UzixLS/murmulator1010-board/release/pcb.rev.A1.pdf

1 | 2 | 3 | 4 | 5 | 6 | 7 | 8 | 9

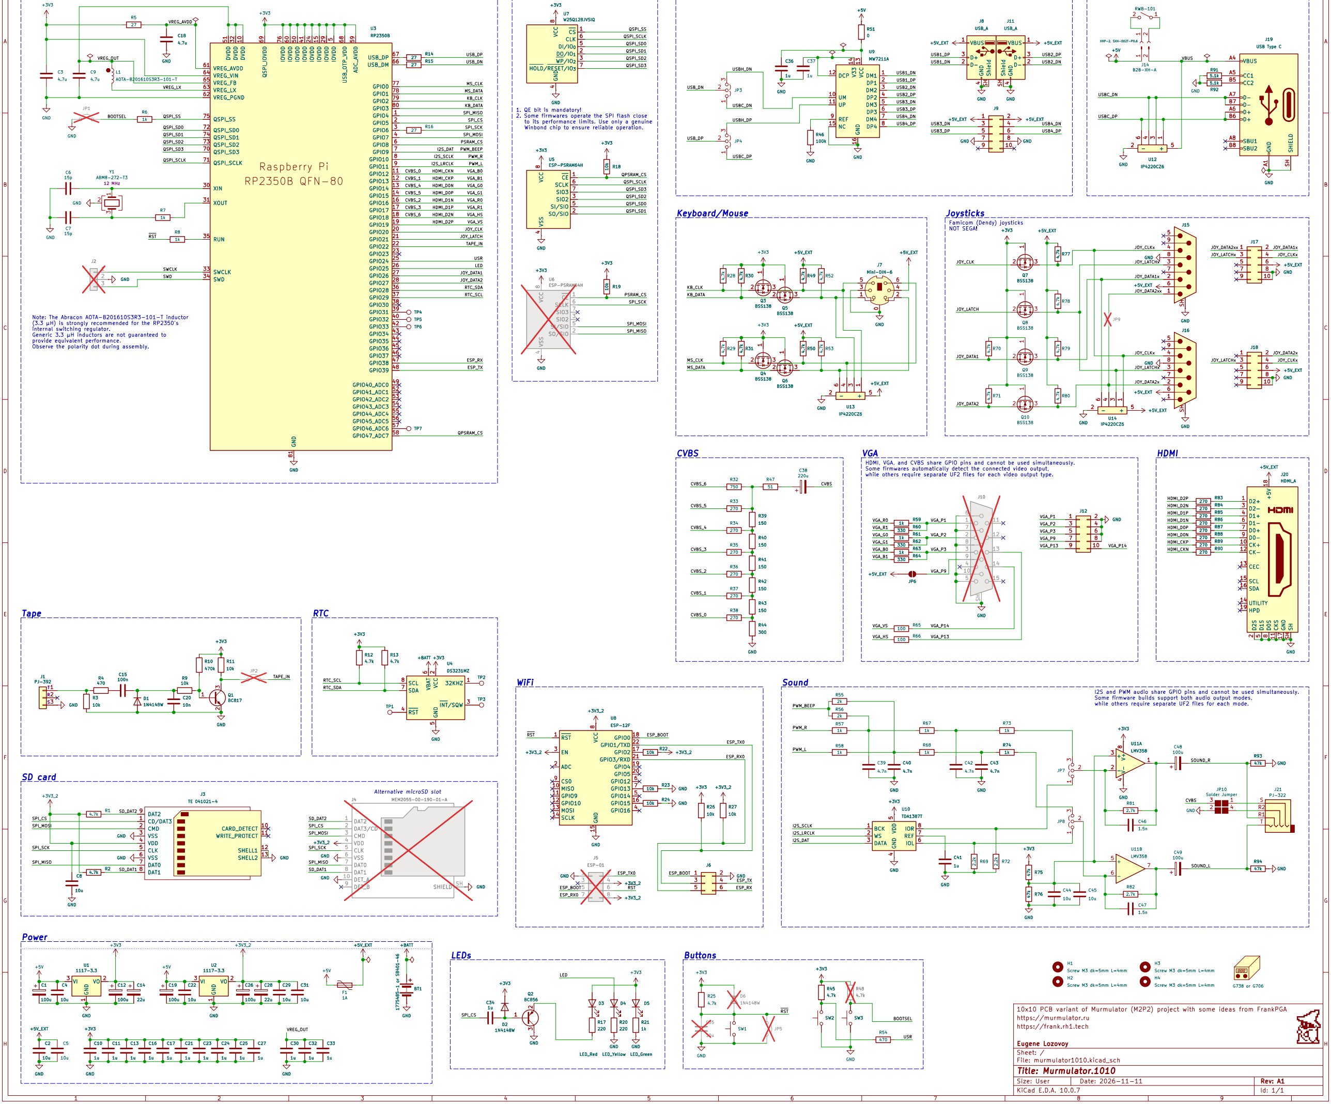
[picture p5: figure]
FGH; FGH Date: 2026-11-11; KiCad E.D.A. 10.0.7; Size: User; Rev: A1; Title: Murmulator.1010; File: murmulator1010.kicad_sch; Sheet: /; Eugene Lozovoy; https://frank.rh1.tech; https://murmulator.ru; GND; GND 1; GND +3V3 GND; 10k GND; JP3 R18 10k +3V3 GND; 10k +3V3_2 +3V3_2 GND; ESP-01; J6 R22 10k RST 1; ADC 2; ESP-12F +3V3_2; +3V3_2 GND; SO/SIO 2; SIO2 3 VSS; SI/SIO 5; SCLK 6; SIO3 7 VCC; ESP-PSRAM64H; CKS 11 CK-; 12 CEC; 13 UTILITY 14; SCL 15; SDA 16; GND 17 +⁵V 18 HPD; J20 HDMI_A +3V3 CE 1; U5 ESP-PSRAM64H; 1u GND; 10u GND; GNDGND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
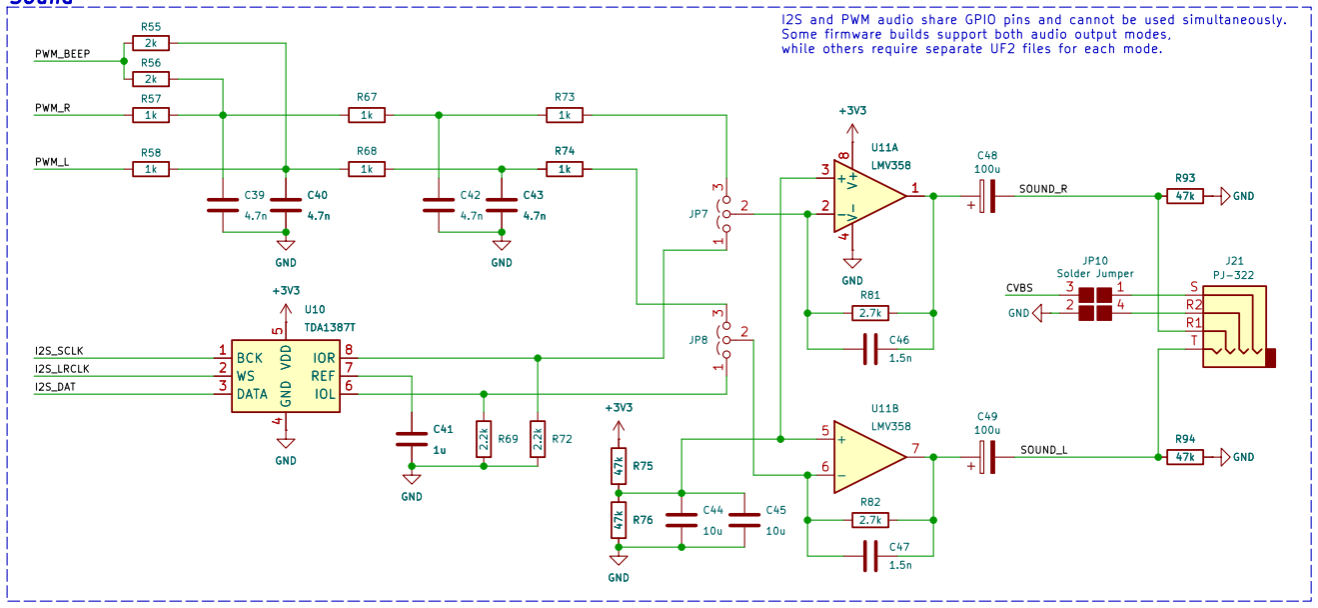
[picture p6: figure]

## 10x10 PCB variant of Murmulator (M2P2) project with some ideas from FrankPGA

EN 3 | GPIO16 4 GPIO14 5 GPIO12 6 GPIO13 7 VCC

# 8 CS0 9 MISO 10 GPIO9 11 GPIO10 12 MOSI 13

SCLK 14 | GND 15 | GPIO15 16 GPIO2 17 GPIO0 18 GPIO4 19 GPIO5 20 GPIO3/RXD 21 GPIO1/TXD 22
GND +5V_EXT | BT1 1775485⁻¹ or S8401⁻⁴⁶ GND +BATT
GND DM1 1 DP1 2 DM2 3 DP2 4 DM3 5 DP3 6 DM4 7 DP4 8 REF 9 UM 10 UP 11 DCP 12 | VCC 13 V33 14 NC 15 | GND 16

5 GPIO8 6 GPIO9 7 GPIO10 8 GPIO11 9 DVDD 10 GPIO12 11 GPIO13 12 GPIO14 13 GPIO15 14 IOVDD 15 GPIO16 16 GPIO17 17 GPIO18 18 GPIO19 19 GPIO20 20 GPIO21 21 GPIO22 22 GPIO23 23 IOVDD 24 GPIO24 25 GPIO25 26 GPIO26 27 GPIO27 28 IOVDD 29

SWD 34 RUN 35 | GPIO28 36 GPIO29 37 GPIO30 38 GPIO31 39 GPIO32 40 IOVDD 41 | GPIO33 42 GPIO34 43 GPIO35 44 GPIO36 45 GPIO37 46 GPIO38 47 GPIO39 48 GPIO40_ADC0 49 IOVDD 50 DVDD 51

GPIO41_ADC1 52 GPIO42_ADC2 53 GPIO43_ADC3 54 GPIO44_ADC4 55 GPIO45_ADC5 56 GPIO46_ADC6 57 GPIO47_ADC7 58 ADC_AVDD 59 IOVDD 60

VREG_FB 65 | USB_DM 66 USB_DP 67 USB_OTP_VDD 68 QSPI_IOVDD 69 QSPI_SD3 70 QSPI_SCLK 71 QSPI_SD0 72 QSPI_SD2 73 QSPI_SD1 74 QSPI_SS 75 | IOVDD 76 | GPIO0 77 GPIO1 78 GPIO2 79 GPIO3 80 GND 81
VSS 6 | DAT0 7 | DAT1 8 | DAT2 9 | CARD_DETECT 10 WRITE_PROTECT 11

# VREG_LX QSPI_SD0 QSPI_SD1 QSPI_SD2 QSPI_SD3 QSPI_SS

QSPI_SCLK QSPI_SD1 QSPI_SD0 QSPI_SD3 QSPI_SD2 QPSRAM_CS | USBH_DN

KB_DATA SPI_MOSI QSPI_SCLK QSPI_SD3 QSPI_SD1 QSPI_SD2 QSPI_SD0

# MCU

HDMI, VGA, and CVBS share GPIO pins and cannot be used simultaneously. Some firmwares automatically detect the connected video output, while others require separate UF2 files for each video output type.

Note: The Abracon AOTA-B201610S3R3-101-T inductor (3.3 µH) is strongly recommended for the RP2350's

## internal switching regulator. Generic 3.3 µH inductors are not guaranteed to

provide equivalent performance. Observe the polarity dot during assembly.

## 1. QE bit is mandatory! 2. Some firmwares operate the SPI flash close

to its performance limits. Use only a genuine Winbond chip to ensure reliable operation.

Power in / USB device FLASH & RAM | USB hub

I2S and PWM audio share GPIO pins and cannot be used simultaneously. Some firmware builds support both audio output modes, while others require separate UF2 files for each mode. GND

100u | +5V_EXT | BT1 1775485⁻¹ or S8401⁻⁴⁶ GND +BATT +3V3_2 GND

## U3RP2350B GPIO4 1 GPIO5 2 GPIO6 3 GPIO7 4 IOVDD

5 GPIO8 6 GPIO9 7 GPIO10 8 GPIO11 9 DVDD 10 GPIO12 11 GPIO13 12 GPIO14 13 GPIO15 14 IOVDD 15 GPIO16 16 GPIO17 17 GPIO18 18 GPIO19 19 GPIO20 20 GPIO21 21 GPIO22 22 GPIO23 23 IOVDD 24 GPIO24 25 GPIO25 26 GPIO26 27 GPIO27 28 IOVDD 29

SWD 34 RUN 35 | GPIO28 36 GPIO29 37 GPIO30 38 GPIO31 39 GPIO32 40 IOVDD 41 | GPIO33 42 GPIO34 43 GPIO35 44 GPIO36 45 GPIO37 46 GPIO38 47 GPIO39 48 GPIO40_ADC0 49 IOVDD 50 DVDD 51

GPIO41_ADC1 52 GPIO42_ADC2 53 GPIO43_ADC3 54 GPIO44_ADC4 55 GPIO45_ADC5 56 GPIO46_ADC6 57 GPIO47_ADC7 58 ADC_AVDD 59 IOVDD 60

VREG_FB 65 | USB_DM 66 USB_DP 67 USB_OTP_VDD 68 QSPI_IOVDD 69 QSPI_SD3 70 QSPI_SCLK 71 QSPI_SD0 72 QSPI_SD2 73 QSPI_SD1 74 QSPI_SS 75 | IOVDD 76 | GPIO0 77 GPIO1 78 GPIO2 79 GPIO3 80 GND 81
VSS 6 | DAT0 7 | DAT1 8 | DAT2 9 | CARD_DETECT 10 WRITE_PROTECT 11

R31 4.7k R30 4.7k R19 10k +3V3 GND U7W25Q128JVSIQ CS 1 DO/IO1 2 WP/IO2 3 GND
+5V_EXT | +5V_EXT +5V R49 4.7k +5V_EXT Q3 BSS138 1
2 | 3⁺⁵V_EXT U9MW7211A DM1 1 DP1 2 DM2 3 DP2 4 DM3 5 DP3 6 DM4 7 DP4 8 REF 9 UM 10 UP 11 DCP 12 | VCC 13 V33 14 NC 15 | GND 16
EN 3 | GPIO16 4 GPIO14 5 GPIO12 6 GPIO13 7 VCC

# 8 CS0 9 MISO 10 GPIO9 11 GPIO10 12 MOSI 13

SCLK 14 | GND 15 | GPIO15 16 GPIO2 17 GPIO0 18 GPIO4 19 GPIO5 20 GPIO3/RXD 21 GPIO1/TXD 22

# R 1.60 mm 7.5 mm

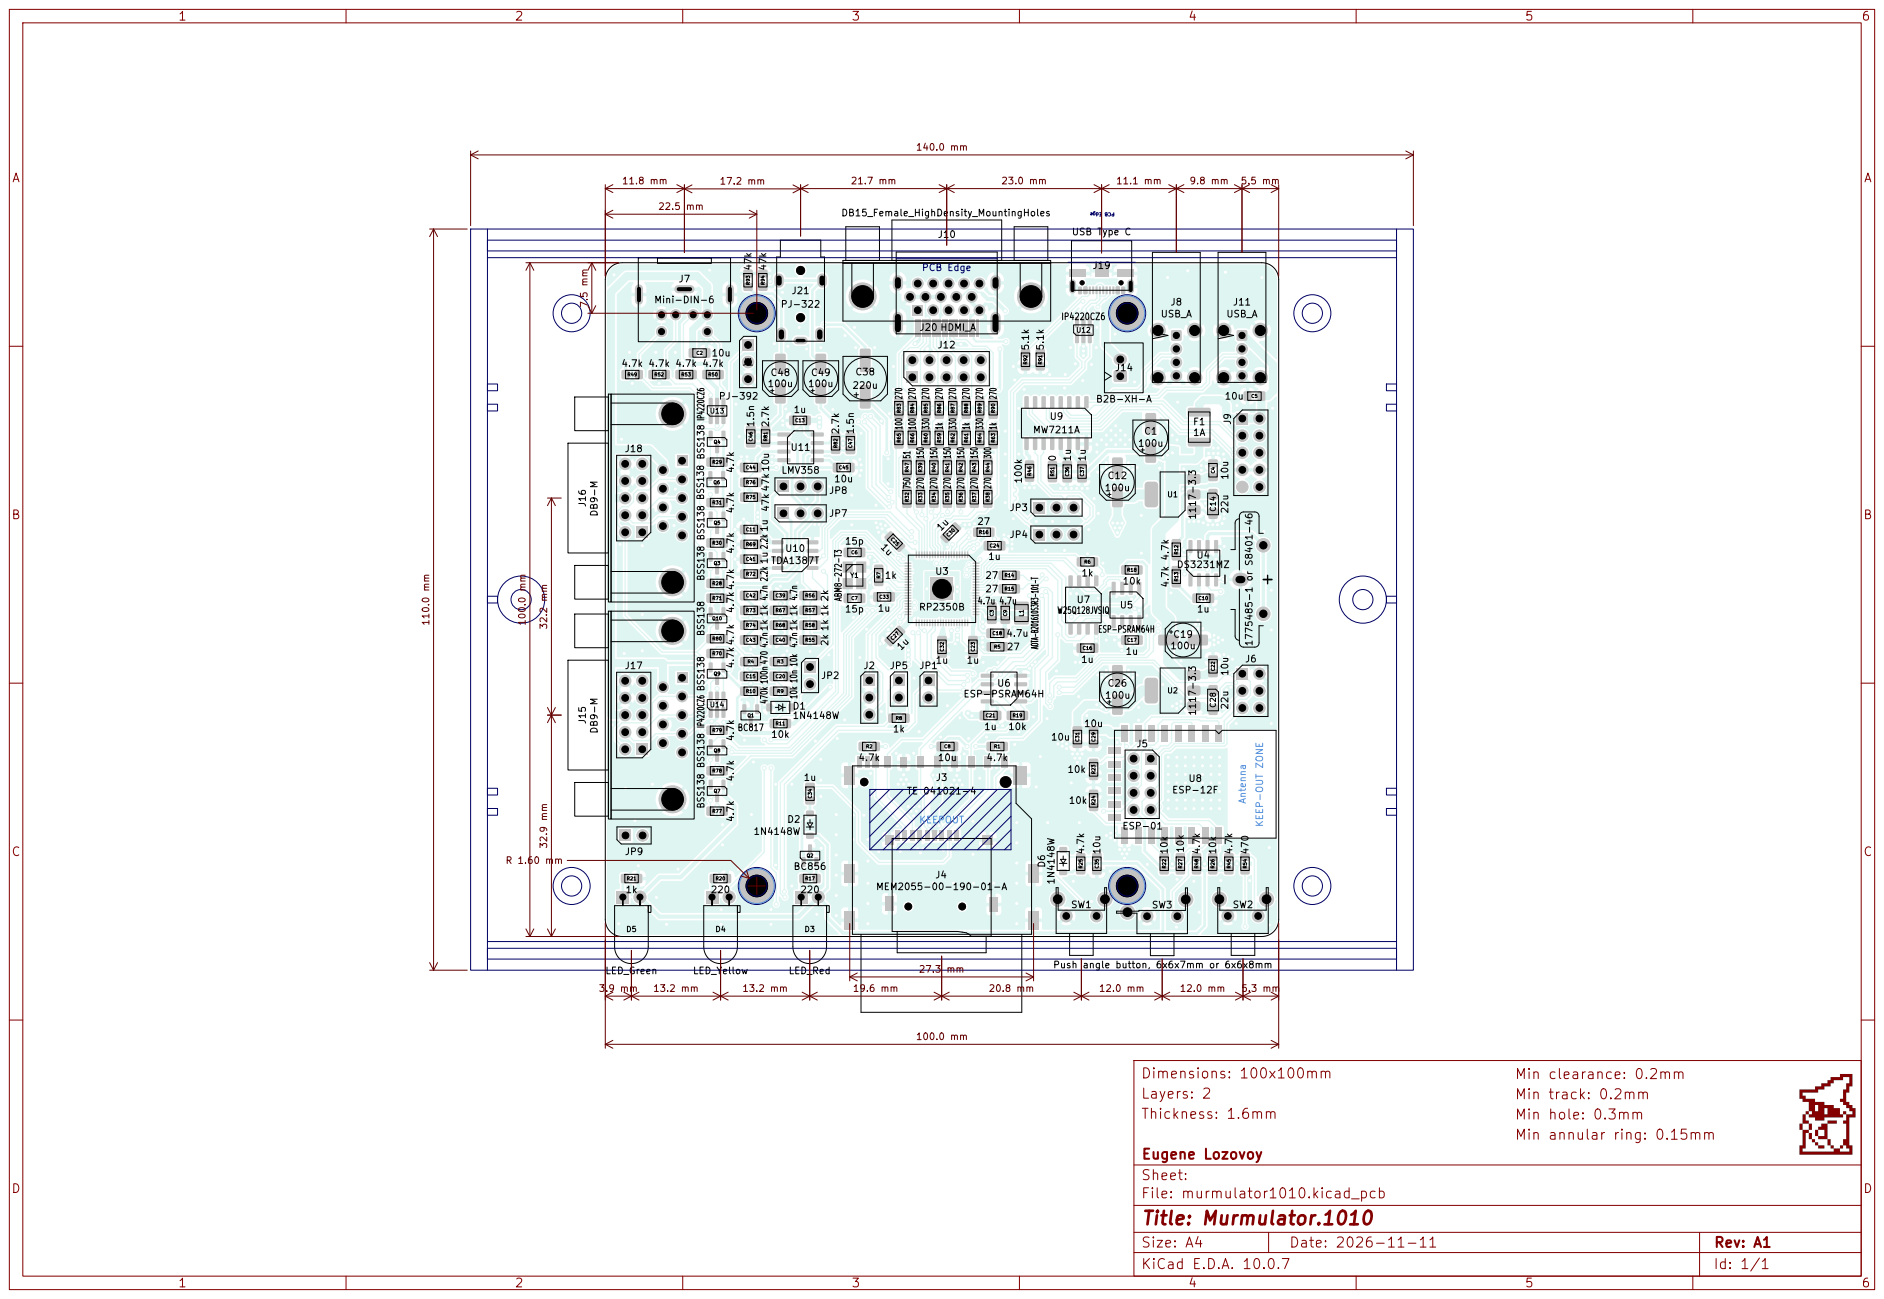
[picture p7: page 2]

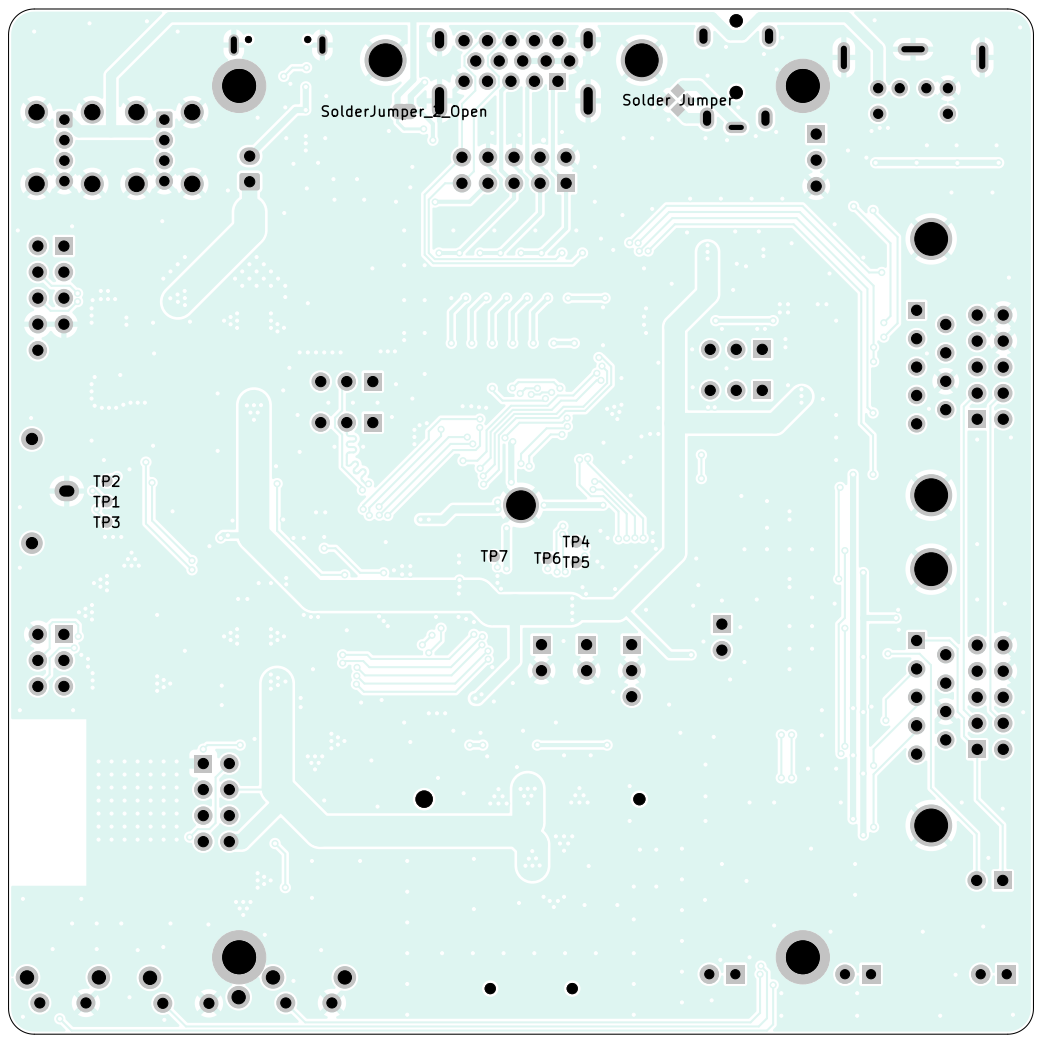
[picture p8: page 3]
D Date: 2026-11-11; KiCad E.D.A. 10.0.7; Size: A4; Rev: A1; Title: Murmulator.1010; File: murmulator1010.kicad_pcb; Sheet:; Eugene Lozovoy; Thickness: 1.6mm; Layers: 2; Dimensions: 100x100mm; Solder Jumper TP3; SolderJumper_2_Open

Min clearance: 0.2mm
Min track: 0.2mm
Min hole: 0.3mm
Min annular ring: 0.15mm

# Bill Of Materials

Refs | | | Value | Footprint | Qty
BT1 | 1775485-1 or S8401-46 | CR2032V | 1
C1 C12 C19 C26 C48 C49 | 100u | CP_Elec_5x5.9 | 6
C2 C4 C5 C8 C22 C29 C31 C44 C45 | 10u | C_0805_2012Metric_Pad1.18x1.45mm_Ha ndSolder | 9
C3 C9 C18 | 4.7u | C_0805_2012Metric_Pad1.18x1.45mm_Ha ndSolder | 3
C6 C7 | 15p | C_0805_2012Metric_Pad1.18x1.45mm_Ha ndSolder | 2
C10 C11 C13 C16 C17 C21 C23 C24 C25 C27 C30 C32 C33 C34 C36 C37 C41 | 1u | C_0805_2012Metric_Pad1.18x1.45mm_Ha ndSolder | 17
C14 C28 | 22u | CP_EIA-3216-18_Kemet-A_HandSolder | 2
C15 | 100n | C_0805_2012Metric_Pad1.18x1.45mm_Ha ndSolder | 1
C20 | 10n | C_0805_2012Metric_Pad1.18x1.45mm_Ha ndSolder | 1
C38 | 220u | CP_Elec_6.3x7.7 | 1
C39 C40 C42 C43 | 4.7n | C_0805_2012Metric_Pad1.18x1.45mm_Ha ndSolder | 4
C46 C47 | 1.5n | C_0805_2012Metric_Pad1.18x1.45mm_Ha ndSolder | 2
D1 D2 | 1N4148W | D_SOD-123 | 2
D3 | LED_Red | LED_D5.0mm_Horizontal_O1.27mm_Z3.0 mm | 1
D4 | LED_Yellow | LED_D5.0mm_Horizontal_O1.27mm_Z3.0 mm | 1
D5 | LED_Green | LED_D5.0mm_Horizontal_O1.27mm_Z3.0 mm | 1
F1 | 1A | Fuse_1812_4532Metric_Pad1.30x3.40mm _HandSolder | 1
H1 H2 H3 H4 | Screw M3 dk=5mm L=4mm | MountingHole_3.2mm_M3_dk5.2mm_Mas k | 4
J1 | PJ-392 | PinHeader_1x03_P2.54mm_Vertical | 1
J3 | TE 041021-4 | SD_TE_2041021-mod | 1
J6 | Conn_02x03_Odd_Even | PinHeader_2x03_P2.54mm_Vertical | 1
J7 | Mini-DIN-6 | minidin-6 | 1
J8 J11 | USB_A | USB_A_Wuerth_614004134726_Horizonta l | 2
J9 J12 J17 J18 | Conn_02x05_Odd_Even | PinHeader_2x05_P2.54mm_Vertical | 4
J13 | XHP-2 SXH-002T-P0.6 | | 1
J14 | B2B-XH-A | JST_XH_B2B-XH-A_1x02_P2.50mm_Vertic al | 1
J15 J16 | DB9-M | DSUB-9_Pins_Horizontal_P2.77x2.84mm_ EdgePinOffset7.70mm_Housed_Mounting HolesOffset9.12mm | 2

# murmulator1010 rev.A1 BOM page 1/3

J19 | USB Type C | USB_C_Receptacle_HRO_TYPE-C-31-M-12_ dangling | 1
J20 | HDMI_A | HDMI_A_Molex_208658-1001_Horizontal | 1
J21 | PJ-322 | PJ-322 | 1
L1 | AOTA-B201610S3R3-101-T | L_1008_2520Metric | 1
N1 | G738 or G706 | g738-g706 | 1
Q1 | BC817 | SOT-23 | 1
Q2 | BC856 | SOT-23 | 1
Q3 Q4 Q5 Q6 Q7 Q8 Q9 Q10 | BSS138 | SOT-23 | 8
R1 R2 R12 R13 R25 R28 R29 R30 R31 R45 R49 R50 R52 R53 R70 R71 R77 R78 R79 R80 | 4.7k | R_0805_2012Metric_Pad1.20x1.40mm_Ha ndSolder | 20
R3 R9 R11 R18 R19 R22 R23 R24 R26 R27 | 10k | R_0805_2012Metric_Pad1.20x1.40mm_Ha ndSolder | 10
R4 R54 | 470 | R_0805_2012Metric_Pad1.20x1.40mm_Ha ndSolder | 2
R5 R14 R15 R16 | 27 | R_0805_2012Metric_Pad1.20x1.40mm_Ha ndSolder | 4
R6 R7 R8 R21 R57 R58 R59 R61 R63 R67 R68 R73 R74 | 1k | R_0805_2012Metric_Pad1.20x1.40mm_Ha ndSolder | 13
R10 | 470k | R_0805_2012Metric_Pad1.20x1.40mm_Ha ndSolder | 1
R17 R20 | 220 | R_0805_2012Metric_Pad1.20x1.40mm_Ha ndSolder | 2
R32 | 750 | R_0805_2012Metric_Pad1.20x1.40mm_Ha ndSolder | 1
R33 R34 R35 R36 R37 R38 R83 R84 R85 R86 R87 R88 R89 R90 | 270 | R_0805_2012Metric_Pad1.20x1.40mm_Ha ndSolder | 14
R39 R40 R41 R42 R43 | 150 | R_0805_2012Metric_Pad1.20x1.40mm_Ha ndSolder | 5
R44 | 300 | R_0805_2012Metric_Pad1.20x1.40mm_Ha ndSolder | 1
R46 | 100k | R_0805_2012Metric_Pad1.20x1.40mm_Ha ndSolder | 1
R47 | 51 | R_0805_2012Metric_Pad1.20x1.40mm_Ha ndSolder | 1
R51 | 0 | R_0805_2012Metric_Pad1.20x1.40mm_Ha ndSolder | 1
R55 R56 | 2k | R_0805_2012Metric_Pad1.20x1.40mm_Ha ndSolder | 2
R60 R62 R64 | 330 | R_0805_2012Metric_Pad1.20x1.40mm_Ha ndSolder | 3
R65 R66 | 100 | R_0805_2012Metric_Pad1.20x1.40mm_Ha ndSolder | 2
R69 R72 | 2.2k | R_0805_2012Metric_Pad1.20x1.40mm_Ha ndSolder | 2
R75 R76 R93 R94 | 47k | R_0805_2012Metric_Pad1.20x1.40mm_Ha ndSolder | 4
R81 R82 | 2.7k | R_0805_2012Metric_Pad1.20x1.40mm_Ha ndSolder | 2

# murmulator1010 rev.A1 BOM page 2/3

R91 R92 | 5.1k | R_0805_2012Metric_Pad1.20x1.40mm_Ha ndSolder | 2
SW1 SW2 SW3 | Push angle button 6x6x7mm or 6x6x8mm | SW_Tactile_SPST_Angled_PTS645Vx58-2L FS | 3
SW4 | RWB-101 | | 1
U1 U2 | 1117-3.3 | SOT-223-3_TabPin2 | 2
U3 | RP2350B | QFN-80-1EP_10x10mm_P0.4mm_EP3.4x3. 4mm | 1
U4 | DS3231MZ | SOIC-8_3.9x4.9mm_P1.27mm | 1
U5 | ESP-PSRAM64H | SOIC-8_3.9x4.9mm_P1.27mm | 1
U7 | W25Q128JVSIQ | SOIC-8_5.3x5.3mm_P1.27mm | 1
U8 | ESP-12F ESP-12E | ESP-12E | 1
U9 | MW7211A | SOP-16_4.4x10.4mm_P1.27mm | 1
U10 | TDA1387T | SO-8_3.9x4.9mm_P1.27mm | 1
U11 | LMV358 | SOIC-8_3.9x4.9mm_P1.27mm | 1
U12 U13 U14 | IP4220CZ6 | SC-74-6_1.55x2.9mm_P0.95mm | 3
Y1 | ABM8-272-T3 | Crystal_SMD_3225-4Pin_3.2x2.5mm_Han dSoldering | 1

# murmulator1010 rev.A1 BOM page 3/3

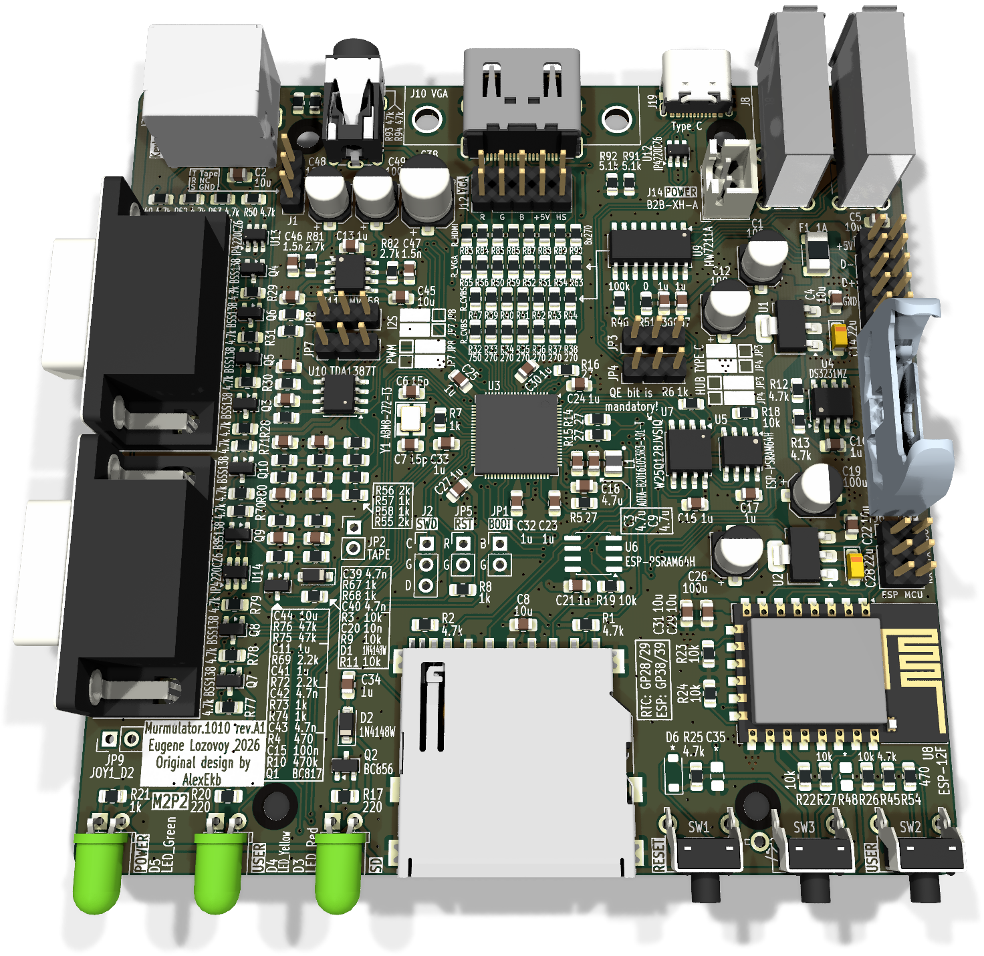
[picture p9: page 7]
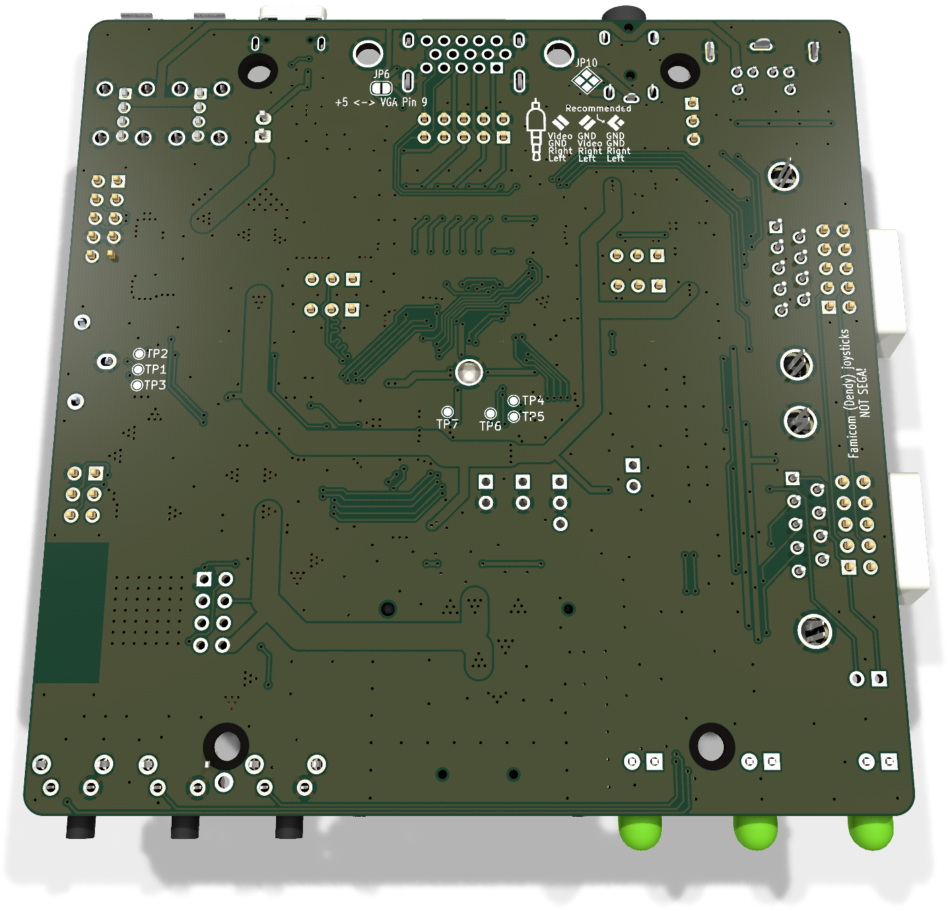
[picture p10: page 8]
