UzixLS/murmulator1010-board/pcb/rev.A1/murmulator1010.kicad_pcb

## KiCad design pcb/rev.A1/murmulator1010.kicad_pcb (2026-11-11)

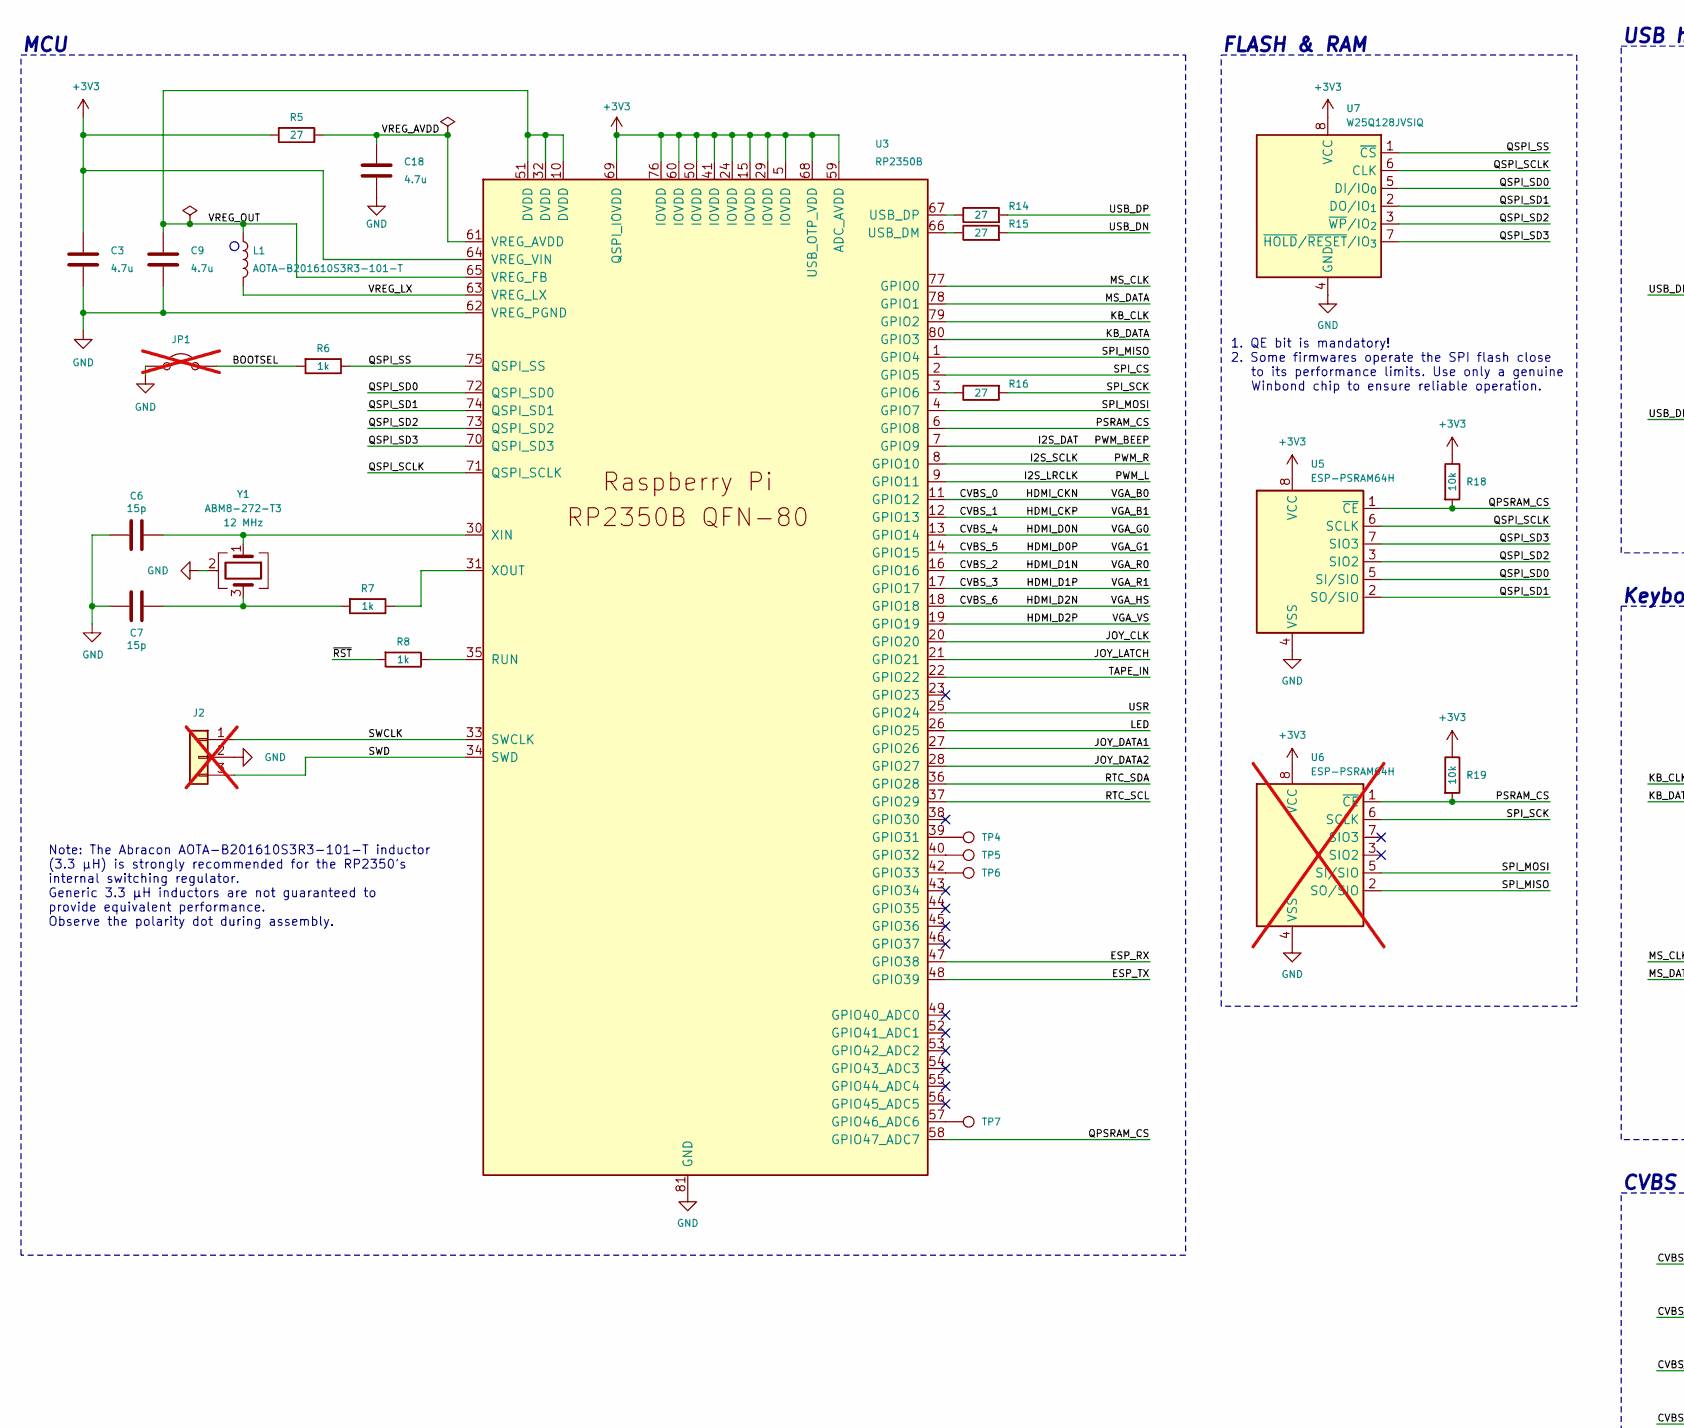
[picture p11: schematic murmulator1010.kicad_sch, Murmulator.1010, part in row 1, column 1]

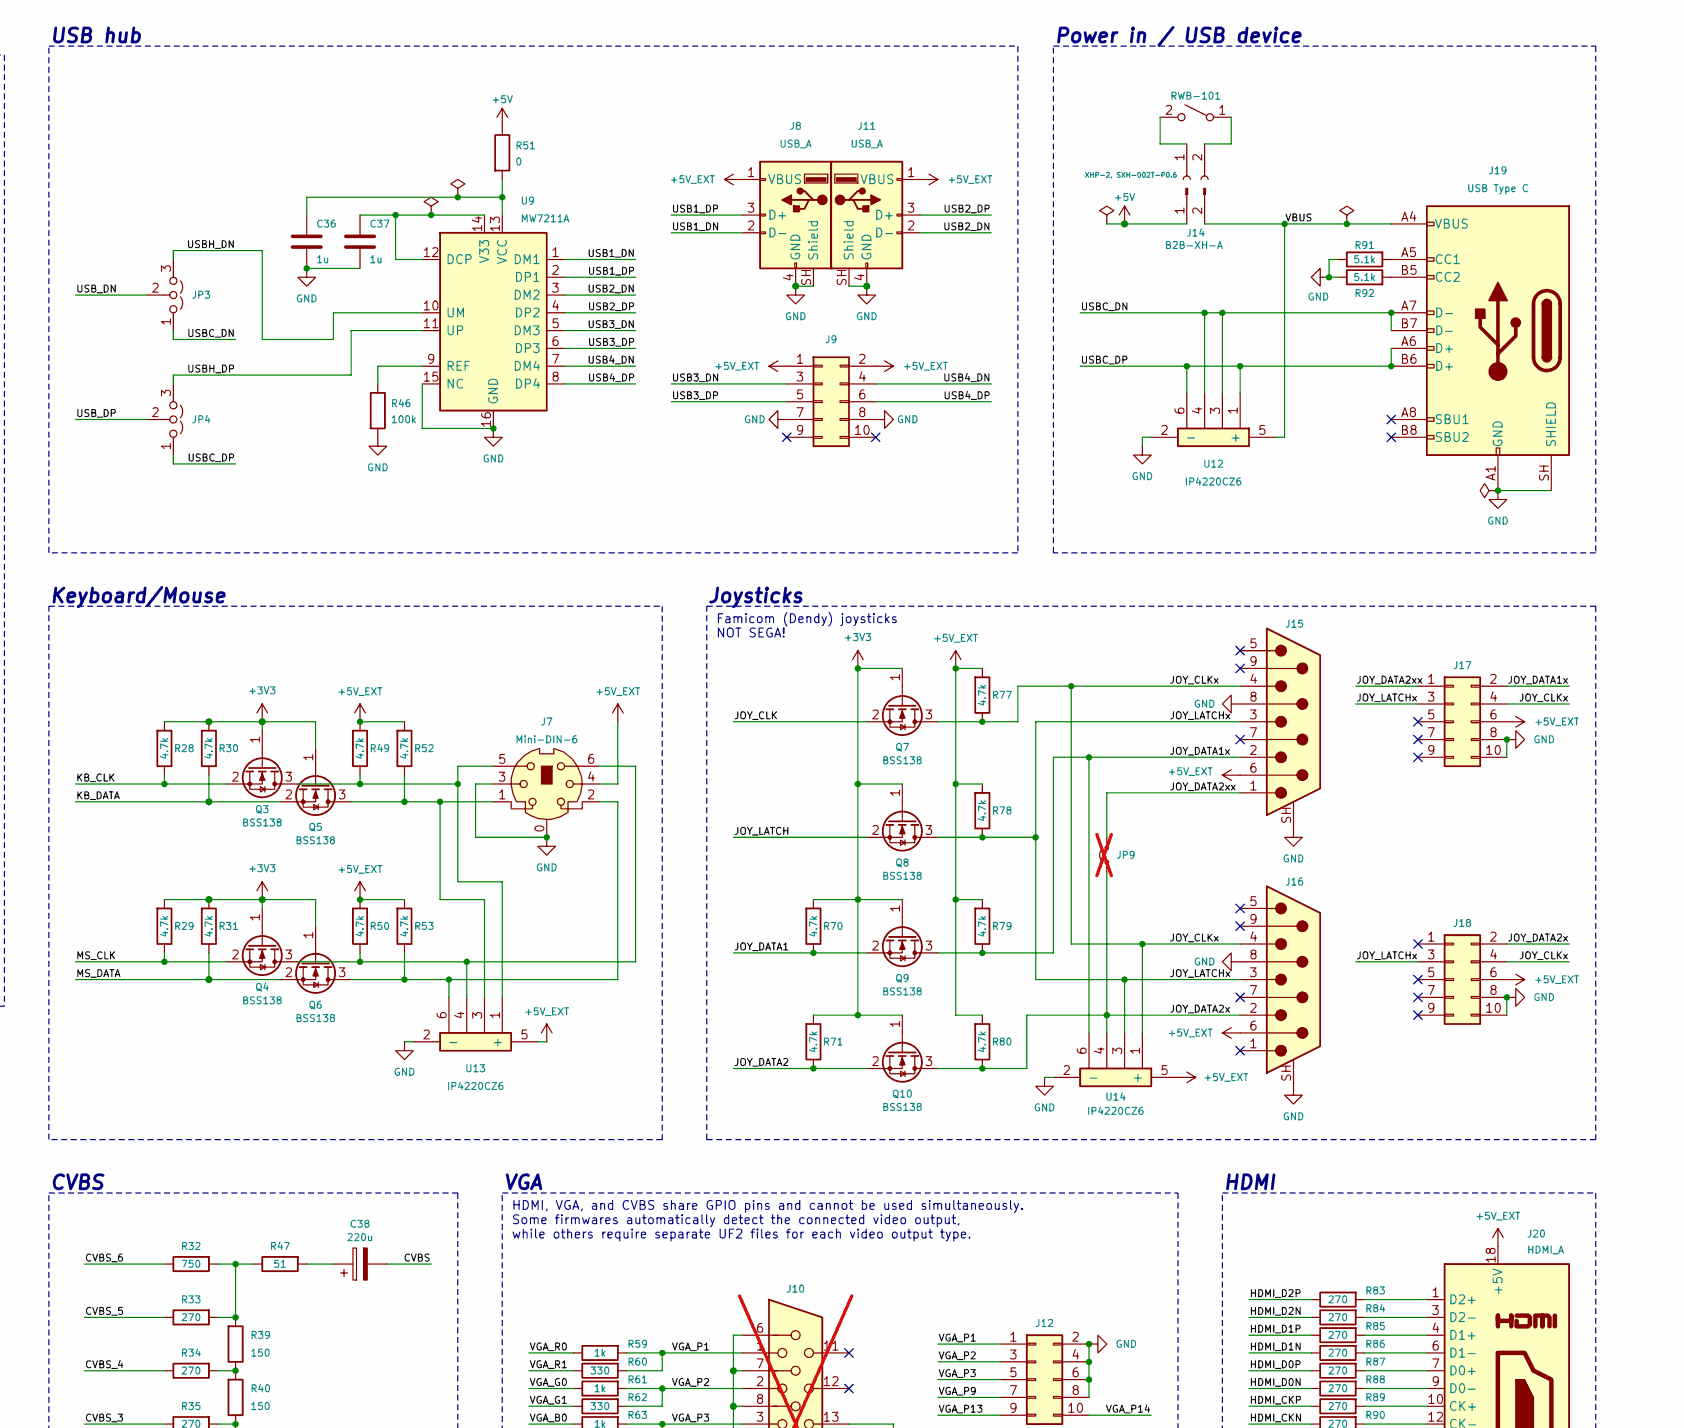
[picture p12: schematic murmulator1010.kicad_sch, Murmulator.1010, part in row 1, column 2]

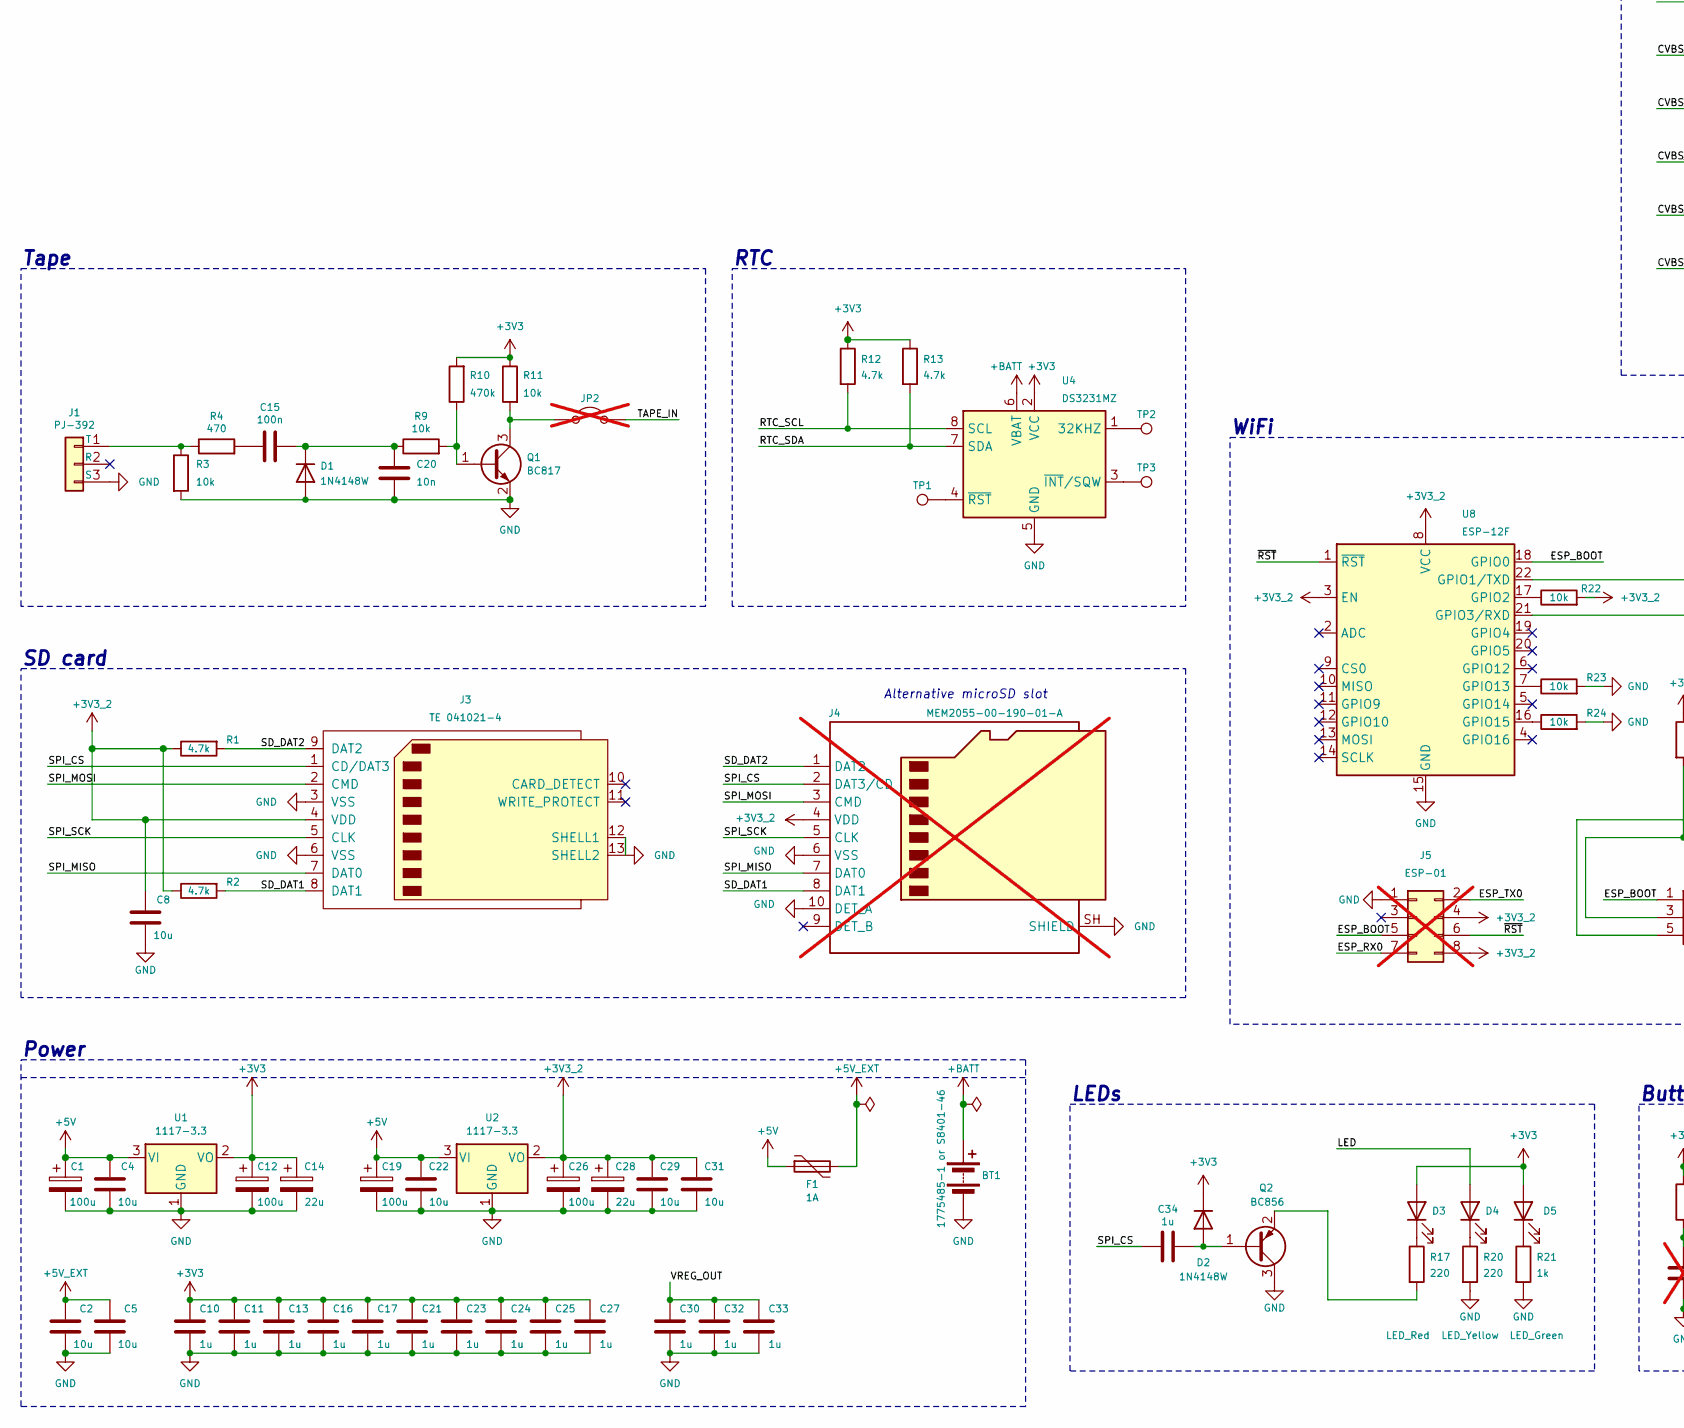
[picture p13: schematic murmulator1010.kicad_sch, Murmulator.1010, part in row 2, column 1]

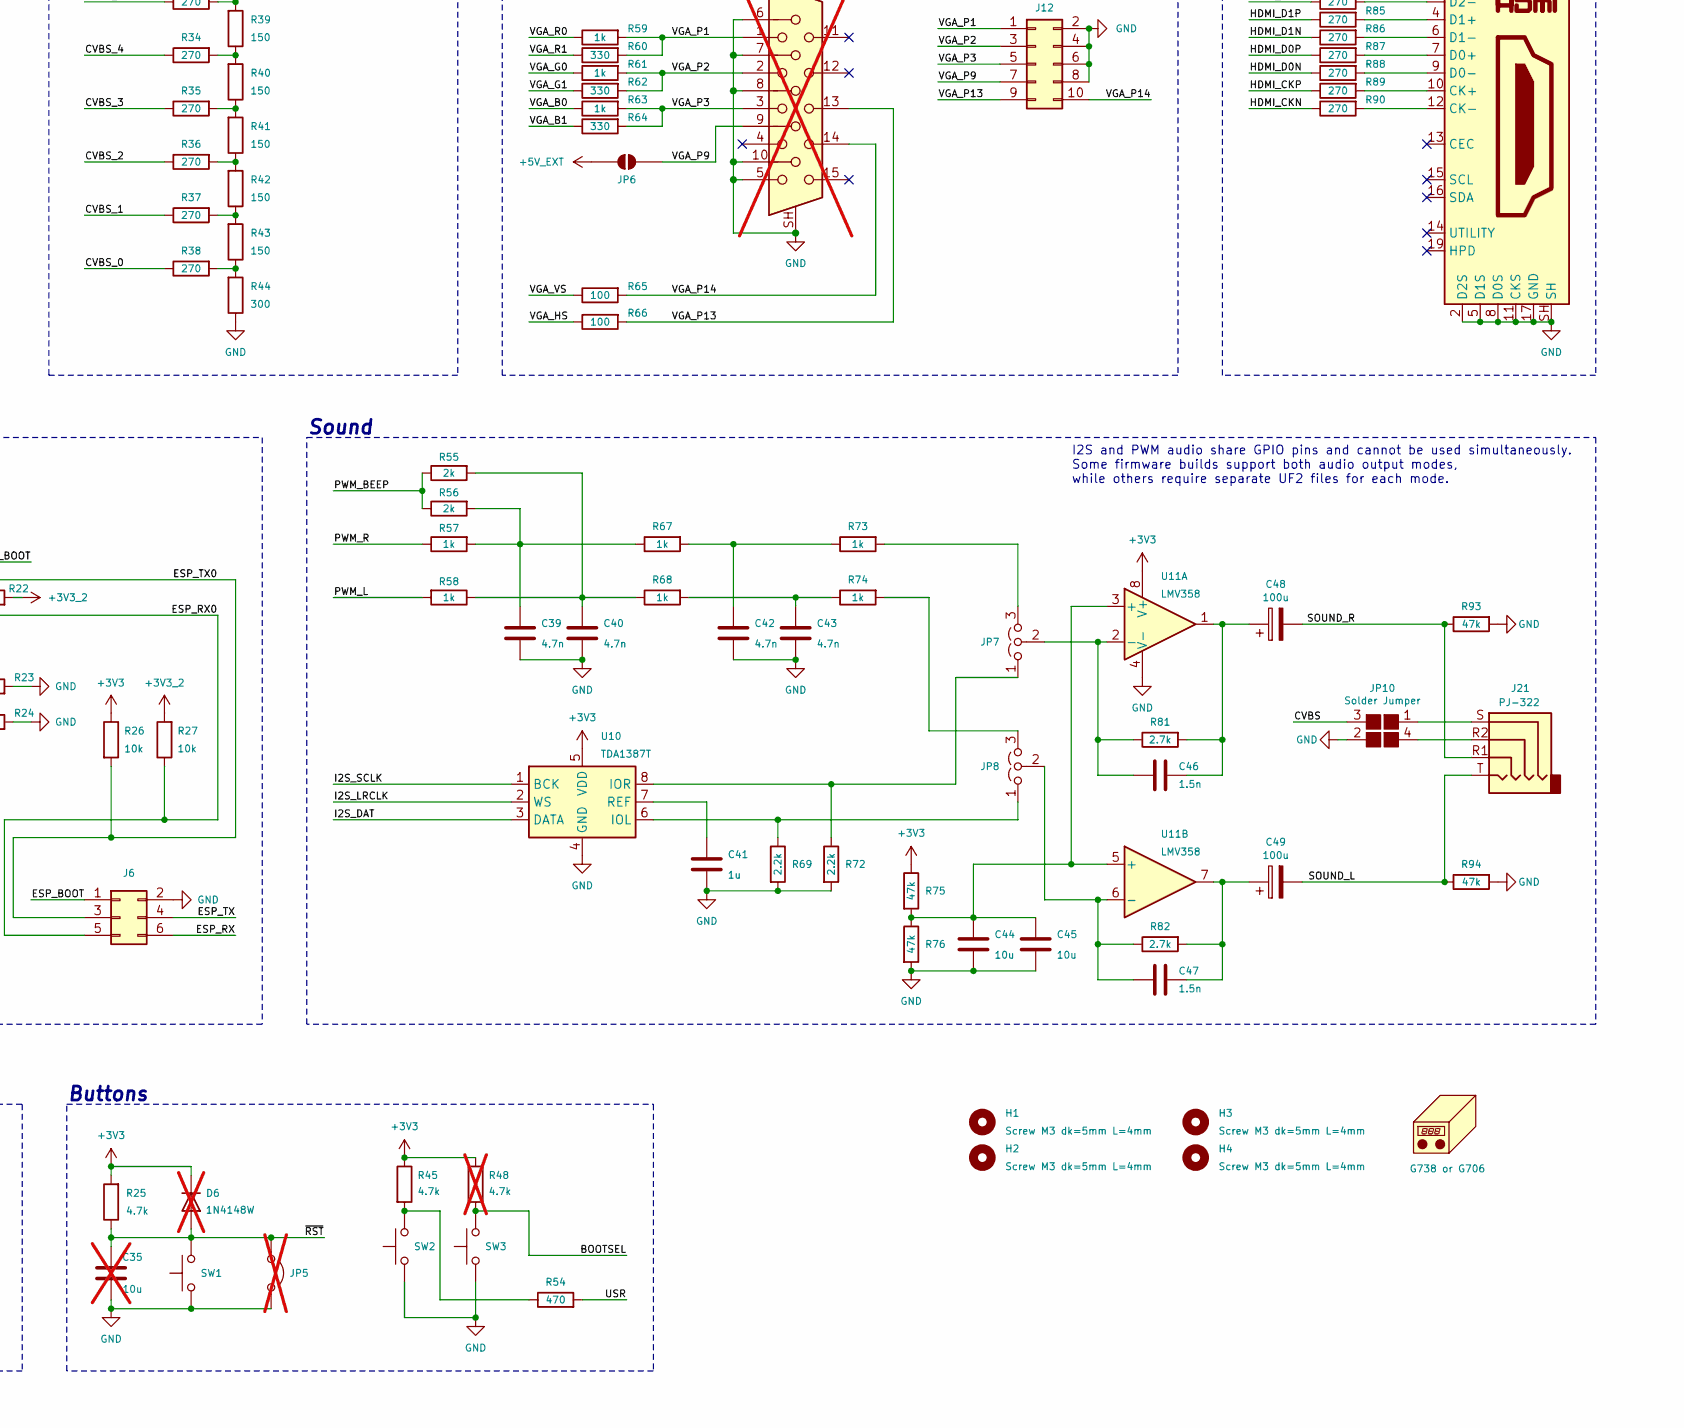
[picture p14: schematic murmulator1010.kicad_sch, Murmulator.1010, part in row 2, column 2]

Parts:
BT1: 1775485-1 or S8401-46; CR2032V
C1, C12, C19, C26, C48, C49: 100u; CP_Elec_5x5.9
C2, C4, C5, C8, C22, C29, C31, C44, C45: 10u; C_0805_2012Metric_Pad1.18x1.45mm_HandSolder
C3, C9, C18: 4.7u; C_0805_2012Metric_Pad1.18x1.45mm_HandSolder
C6, C7: 15p; C_0805_2012Metric_Pad1.18x1.45mm_HandSolder
C10, C11, C13, C16, C17, C21, C23, C24, C25, C27, C30, C32, C33, C34, C36, C37, C41: 1u; C_0805_2012Metric_Pad1.18x1.45mm_HandSolder
C14, C28: 22u; CP_EIA-3216-18_Kemet-A_HandSolder
C15: 100n; C_0805_2012Metric_Pad1.18x1.45mm_HandSolder
C20: 10n; C_0805_2012Metric_Pad1.18x1.45mm_HandSolder
C35: 10u; C_0805_2012Metric_Pad1.18x1.45mm_HandSolder; not fitted
C38: 220u; CP_Elec_6.3x7.7
C39, C40, C42, C43: 4.7n; C_0805_2012Metric_Pad1.18x1.45mm_HandSolder
C46, C47: 1.5n; C_0805_2012Metric_Pad1.18x1.45mm_HandSolder
D1, D2: 1N4148W; D_SOD-123
D3: LED_Red; LED_D5.0mm_Horizontal_O1.27mm_Z3.0mm
D4: LED_Yellow; LED_D5.0mm_Horizontal_O1.27mm_Z3.0mm
D5: LED_Green; LED_D5.0mm_Horizontal_O1.27mm_Z3.0mm
D6: 1N4148W; D_SOD-123; not fitted
F1: 1A; Fuse_1812_4532Metric_Pad1.30x3.40mm_HandSolder
H1, H2, H3, H4: Screw M3 dk=5mm L=4mm; MountingHole_3.2mm_M3_dk5.2mm_Mask
J1: PJ-392; PinHeader_1x03_P2.54mm_Vertical
J2: Conn_01x03; PinHeader_1x03_P2.54mm_Vertical; not fitted
J3: TE 041021-4; SD_TE_2041021-mod
J4: MEM2055-00-190-01-A; microSD_GCT-MEM2055-00-190-01-A; not fitted
J5: ESP-01; PinSocket_2x04_P2.54mm_Vertical; not fitted
J6: Conn_02x03_Odd_Even; PinHeader_2x03_P2.54mm_Vertical
J7: Mini-DIN-6; minidin-6
J8, J11: USB_A; USB_A_Wuerth_614004134726_Horizontal
J9, J12, J17, J18: Conn_02x05_Odd_Even; PinHeader_2x05_P2.54mm_Vertical
J10: DB15_Female_HighDensity_MountingHoles; DSUB-15-HD_Female_Horizontal_P2.29x1.98mm_EdgePinOffset3.03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; not fitted
J13: XHP-2, SXH-002T-P0.6
J14: B2B-XH-A; JST_XH_B2B-XH-A_1x02_P2.50mm_Vertical
J15, J16: DB9-M; DSUB-9_Pins_Horizontal_P2.77x2.84mm_EdgePinOffset7.70mm_Hou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
J19: USB Type C; USB_C_Receptacle_HRO_TYPE-C-31-M-12_dangling
J20: HDMI_A; HDMI_A_Molex_208658-1001_Horizontal
J21: PJ-322
JP1, JP2: Jumper_2_Open; PinHeader_1x02_P2.54mm_Vertical; not fitted
JP3, JP4, JP7, JP8: Jumper_3_Open; PinHeader_1x03_P2.54mm_Vertical
JP5, JP9: Jumper_2_Small_Open; PinHeader_1x02_P2.54mm_Vertical; not fitted
JP6: SolderJumper_2_Open; SolderJumper-2_P1.3mm_Open_RoundedPad1.0x1.5mm
JP10: Solder Jumper; SolderJumper-4_P1.3mm_Open
L1: AOTA-B201610S3R3-101-T; L_1008_2520Metric
N1: G738 or G706; g738-g706
Q1: BC817; SOT-23
Q2: BC856; SOT-23
Q3, Q4, Q5, Q6, Q7, Q8, Q9, Q10: BSS138; SOT-23
R1, R2, R12, R13, R25, R28, R29, R30, R31, R45, R49, R50, R52, R53, R70, R71, R77, R78, R79, R80: 4.7k; R_0805_2012Metric_Pad1.20x1.40mm_HandSolder
R3, R9, R11, R18, R19, R22, R23, R24, R26, R27: 10k; R_0805_2012Metric_Pad1.20x1.40mm_HandSolder
R4, R54: 470; R_0805_2012Metric_Pad1.20x1.40mm_HandSolder
R5, R14, R15, R16: 27; R_0805_2012Metric_Pad1.20x1.40mm_HandSolder
R6, R7, R8, R21, R57, R58, R59, R61, R63, R67, R68, R73, R74: 1k; R_0805_2012Metric_Pad1.20x1.40mm_HandSolder
R10: 470k; R_0805_2012Metric_Pad1.20x1.40mm_HandSolder
R17, R20: 220; R_0805_2012Metric_Pad1.20x1.40mm_HandSolder
R32: 750; R_0805_2012Metric_Pad1.20x1.40mm_HandSolder
R33, R34, R35, R36, R37, R38, R83, R84, R85, R86, R87, R88, R89, R90: 270; R_0805_2012Metric_Pad1.20x1.40mm_HandSolder
R39, R40, R41, R42, R43: 150; R_0805_2012Metric_Pad1.20x1.40mm_HandSolder
R44: 300; R_0805_2012Metric_Pad1.20x1.40mm_HandSolder
R46: 100k; R_0805_2012Metric_Pad1.20x1.40mm_HandSolder
R47: 51; R_0805_2012Metric_Pad1.20x1.40mm_HandSolder
R48: 4.7k; R_0805_2012Metric_Pad1.20x1.40mm_HandSolder; not fitted
R51: 0; R_0805_2012Metric_Pad1.20x1.40mm_HandSolder
R55, R56: 2k; R_0805_2012Metric_Pad1.20x1.40mm_HandSolder
R60, R62, R64: 330; R_0805_2012Metric_Pad1.20x1.40mm_HandSolder
R65, R66: 100; R_0805_2012Metric_Pad1.20x1.40mm_HandSolder
R69, R72: 2.2k; R_0805_2012Metric_Pad1.20x1.40mm_HandSolder
R75, R76, R93, R94: 47k; R_0805_2012Metric_Pad1.20x1.40mm_HandSolder
R81, R82: 2.7k; R_0805_2012Metric_Pad1.20x1.40mm_HandSolder
R91, R92: 5.1k; R_0805_2012Metric_Pad1.20x1.40mm_HandSolder
SW1, SW2, SW3: Push angle button, 6x6x7mm or 6x6x8mm; SW_Tactile_SPST_Angled_PTS645Vx58-2LFS
SW4: RWB-101
TP1, TP2, TP3, TP4, TP5, TP6, TP7: TestPoint; TestPoint_Pad_D1.0mm
U1, U2: 1117-3.3; SOT-223-3_TabPin2
U3: RP2350B; QFN-80-1EP_10x10mm_P0.4mm_EP3.4x3.4mm
U4: DS3231MZ; SOIC-8_3.9x4.9mm_P1.27mm
U5: ESP-PSRAM64H; SOIC-8_3.9x4.9mm_P1.27mm
U6: ESP-PSRAM64H; SOIC-8_3.9x4.9mm_P1.27mm; not fitted
U7: W25Q128JVSIQ; SOIC-8_5.3x5.3mm_P1.27mm
U8: ESP-12F; ESP-12E
U9: MW7211A; SOP-16_4.4x10.4mm_P1.27mm
U10: TDA1387T; SO-8_3.9x4.9mm_P1.27mm
U11: LMV358; SOIC-8_3.9x4.9mm_P1.27mm
U12, U13, U14: IP4220CZ6; SC-74-6_1.55x2.9mm_P0.95mm
Y1: ABM8-272-T3; Crystal_SMD_3225-4Pin_3.2x2.5mm_HandSoldering

Connections:
+3V3: C3.1, C10.2, C11.2, C12.1, C13.2, C14.1, C16.2, C17.2, C21.2, C23.2, C24.2, C25.2, C27.2, D2.1 (K), D3.2 (A), D5.2 (A), D6.1 (K), Q3.1 (G), Q4.1 (G), Q5.1 (G), Q6.1 (G), Q7.1 (G), Q8.1 (G), Q9.1 (G), Q10.1 (G), R5.1, R10.2, R11.1, R12.1, R13.1, R18.1, R19.1, R25.2, R26.1, R28.2, R29.2, R30.2, R31.2, R45.1, R48.1, R70.2, R71.2, R75.1, U1.2 (VO), U3.5 (IOVDD), U3.15 (IOVDD), U3.24 (IOVDD), U3.29 (IOVDD), U3.41 (IOVDD), U3.50 (IOVDD), U3.59 (ADC_AVDD), U3.60 (IOVDD), U3.64 (VREG_VIN), U3.68 (USB_OTP_VDD), U3.69 (QSPI_IOVDD), U3.76 (IOVDD), U4.2 (VCC), U5.8 (VCC), U6.8 (VCC), U7.8 (VCC), U10.5 (VDD), U11.8 (V+)
+3V3_2: C8.2, C26.1, C28.1, C29.2, C31.2, J3.4 (VDD), J4.4 (VDD), J5.4, J5.8, R1.1, R2.1, R22.2, R27.2, U2.2 (VO), U8.3 (EN), U8.8 (VCC)
+5V: C1.1, C4.2, C19.1, C22.2, F1.1, J14.1, R51.1, U1.3 (VI), U2.3 (VI)
+5V_EXT: C2.2, C5.2, F1.2, J7.4, J8.1 (VBUS), J9.1, J9.2, J11.1 (VBUS), J15.6, J16.6, J17.6, J18.6, J20.18 (+5V), JP6.2 (B), R49.2, R50.2, R52.2, R53.2, R77.2, R78.2, R79.2, R80.2, U13.5 (+), U14.5 (+)
+BATT: BT1.1 (+), U4.6 (VBAT)
/BOOTSEL: JP1.1 (A), R6.2, R48.2, SW3.1
/CVBS: C38.2, JP10.3
/CVBS_0: R38.1, R63.1, R90.1, U3.11 (GPIO12)
/CVBS_1: R37.1, R64.1, R89.1, U3.12 (GPIO13)
/CVBS_2: R36.1, R59.1, R86.1, U3.16 (GPIO16)
/CVBS_3: R35.1, R60.1, R85.1, U3.17 (GPIO17)
/CVBS_4: R34.1, R61.1, R88.1, U3.13 (GPIO14)
/CVBS_5: R33.1, R62.1, R87.1, U3.14 (GPIO15)
/CVBS_6: R32.1, R66.1, R84.1, U3.18 (GPIO18)
/ESP_BOOT: J5.5, J6.1, U8.18 (GPIO0)
/ESP_RX: J6.6, U3.47 (GPIO38)
/ESP_RX0: J5.7, J6.5, R27.1, U8.21 (GPIO3/RXD)
/ESP_TX: J6.4, U3.48 (GPIO39)
/ESP_TX0: J5.2, J6.3, R26.2, U8.22 (GPIO1/TXD)
/HDMI_D2P: R65.1, R83.1, U3.19 (GPIO19)
/I2S_DAT: R55.1, R56.1, U3.7 (GPIO9), U10.3 (DATA)
/I2S_LRCLK: R58.2, U3.9 (GPIO11), U10.2 (WS)
/I2S_SCLK: R57.1, U3.8 (GPIO10), U10.1 (BCK)
/JOY_CLK: Q7.2 (S), U3.20 (GPIO20)
/JOY_CLKx: J15.4, J16.4, J17.4, J18.4, Q7.3 (D), R77.1, U14.1
/JOY_DATA1: Q9.2 (S), R70.1, U3.27 (GPIO26)
/JOY_DATA1x: J15.2, J17.2, Q9.3 (D), R79.1, U14.6
/JOY_DATA2: Q10.2 (S), R71.1, U3.28 (GPIO27)
/JOY_DATA2x: J16.2, J18.2, JP9.2 (B), Q10.3 (D), R80.1, U14.4
/JOY_DATA2xx: J15.1, J17.1, JP9.1 (A)
/JOY_LATCH: Q8.2 (S), U3.21 (GPIO21)
/JOY_LATCHx: J15.3, J16.3, J17.3, J18.3, Q8.3 (D), R78.1, U14.3
/KB_CLK: Q3.2 (S), R28.1, U3.79 (GPIO2)
/KB_DATA: Q5.2 (S), R30.1, U3.80 (GPIO3)
/LED: D4.2 (A), U3.26 (GPIO25)
/MS_CLK: Q4.2 (S), R29.1, U3.77 (GPIO0)
/MS_DATA: Q6.2 (S), R31.1, U3.78 (GPIO1)
/PSRAM_CS: R19.2, U3.6 (GPIO8), U6.1 (~CE)
/QPSRAM_CS: R18.2, U3.58 (GPIO47_ADC7), U5.1 (~CE)
/QSPI_SCLK: U3.71 (QSPI_SCLK), U5.6 (SCLK), U7.6 (CLK)
/QSPI_SD0: U3.72 (QSPI_SD0), U5.5 (SI/SIO), U7.5 (DI/IO_{0})
/QSPI_SD1: U3.74 (QSPI_SD1), U5.2 (SO/SIO), U7.2 (DO/IO_{1})
/QSPI_SD2: U3.73 (QSPI_SD2), U5.3 (SIO2), U7.3 (~WP/IO_{2})
/QSPI_SD3: U3.70 (QSPI_SD3), U5.7 (SIO3), U7.7 (~HOLD/~RESET/IO_{3})
/QSPI_SS: R6.1, U3.75 (QSPI_SS), U7.1 (~CS)
/RTC_SCL: R12.2, U3.37 (GPIO29), U4.8 (SCL)
/RTC_SDA: R13.2, U3.36 (GPIO28), U4.7 (SDA)
/SD_DAT1: J3.8 (DAT1), J4.8 (DAT1), R2.2
/SD_DAT2: J3.9 (DAT2), J4.1 (DAT2), R1.2
/SOUND_L: C49.2, J21.T, R94.1
/SOUND_R: C48.2, J21.R1, R93.1
/SPI_CS: C34.1, J3.1 (CD/DAT3), J4.2 (DAT3/CD), U3.2 (GPIO5)
/SPI_MISO: J3.7 (DAT0), J4.7 (DAT0), U3.1 (GPIO4), U6.2 (SO/SIO)
/SPI_MOSI: J3.2 (CMD), J4.3 (CMD), U3.4 (GPIO7), U6.5 (SI/SIO)
/SPI_SCK: J3.5 (CLK), J4.5 (CLK), R16.2, U6.6 (SCLK)
/SWCLK: J2.1, U3.33 (SWCLK)
/SWD: J2.3, U3.34 (SWD)
/TAPE_IN: JP2.1 (A), U3.22 (GPIO22)
/USB1_DN: J8.2 (D-), U9.1 (DM1)
/USB1_DP: J8.3 (D+), U9.2 (DP1)
/USB2_DN: J11.2 (D-), U9.3 (DM2)
/USB2_DP: J11.3 (D+), U9.4 (DP2)
/USB3_DN: J9.3, U9.5 (DM3)
/USB3_DP: J9.5, U9.6 (DP3)
/USB4_DN: J9.4, U9.7 (DM4)
/USB4_DP: J9.6, U9.8 (DP4)
/USBC_DN: J19.A7 (D-), J19.B7 (D-), JP3.1 (A), U12.3, U12.4
/USBC_DP: J19.A6 (D+), J19.B6 (D+), JP4.1 (A), U12.1, U12.6
/USBH_DN: JP3.3 (B), U9.10 (UM)
/USBH_DP: JP4.3 (B), U9.11 (UP)
/USB_DN: JP3.2 (C), R15.2
/USB_DP: JP4.2 (C), R14.2
/USR: R54.2, U3.25 (GPIO24)
/VBUS: J14.2, J19.A4 (VBUS), J19.A9 (VBUS), J19.B4 (VBUS), J19.B9 (VBUS), U12.5 (+)
/VGA_P1: J10.1, J12.1, R59.2, R60.2
/VGA_P2: J10.2, J12.3, R61.2, R62.2
/VGA_P3: J10.3, J12.5, R63.2, R64.2
/VGA_P9: J10.9, J12.7, JP6.1 (A)
/VGA_P13: J10.13, J12.9, R66.2
/VGA_P14: J10.14, J12.10, R65.2
/VREG_AVDD: C18.1, R5.2, U3.61 (VREG_AVDD)
/VREG_LX: L1.2, U3.63 (VREG_LX)
/VREG_OUT: C9.1, C30.2, C32.2, C33.2, L1.1, U3.10 (DVDD), U3.32 (DVDD), U3.51 (DVDD), U3.65 (VREG_FB)
/~RST: C35.2, D6.2 (A), J5.6, JP5.1 (A), R8.2, R25.1, SW1.1, U8.1 (~RST)
GND: BT1.2 (-), C1.2, C2.1, C3.2, C4.1, C5.1, C6.2, C7.2, C8.1, C9.2, C10.1, C11.1, C12.2, C13.1, C14.2, C16.1, C17.1, C18.2, C19.2, C20.2, C21.1, C22.1, C23.1, C24.1, C25.1, C26.2, C27.1, C28.2, C29.1, C30.1, C31.1, C32.1, C33.1, C35.1, C36.1, C37.1, C39.2, C40.2, C41.2, C42.2, C43.2, C44.2, C45.2, D1.2 (A), J1.3, J2.2, J3.3 (VSS), J3.6 (VSS), J3.12 (SHELL1), J3.13 (SHELL2), J4.6 (VSS), J4.10 (DET_A), J4.SH (SHIELD), J5.1, J6.2, J7.0, J7.3, J8.4 (GND), J8.SH (Shield), J9.7, J9.8, J10.5, J10.6, J10.7, J10.8, J10.10, J10.SH, J11.4 (GND), J11.SH (Shield), J12.2, J12.4, J12.6, J12.8, J15.8, J15.SH (PAD), J16.8, J16.SH (PAD), J17.8, J17.10, J18.8, J18.10, J19.A1 (GND), J19.A12 (GND), J19.B1 (GND), J19.B12 (GND), J19.SH (SHIELD), J20.2 (D2S), J20.5 (D1S), J20.8 (D0S), J20.11 (CKS), J20.17 (GND), J20.SH, JP1.2 (B), JP5.2 (B), JP10.2, Q1.2 (E), Q2.3 (C), R3.2, R20.2, R21.2, R23.2, R24.2, R44.1, R46.2, R69.2, R72.2, R76.2, R91.1, R92.1, R93.2, R94.2, SW1.2, SW2.2, SW3.2, U1.1 (GND), U2.1 (GND), U3.62 (VREG_PGND), U3.81 (GND), U4.5 (GND), U5.4 (VSS), U6.4 (VSS), U7.4 (GND), U8.15 (GND), U9.15 (NC), U9.16 (GND), U10.4 (GND), U11.4 (V-), U12.2 (-), U13.2 (-), U14.2 (-), Y1.2 (G), Y1.4 (G)
unnamed: C7.1, R7.2, Y1.3
unnamed: C15.2, R4.2
unnamed: C38.1, R47.2
unnamed: C39.1, R56.2, R57.2, R67.1
unnamed: C40.1, R55.2, R58.1, R68.1
unnamed: C42.1, R67.2, R73.1
unnamed: C43.1, R68.2, R74.1
unnamed: C46.1, C48.1, R81.2, U11.1
unnamed: C47.1, C49.1, R82.2, U11.7
unnamed: C15.1, C20.1, D1.1 (K), R9.1
unnamed: C34.2, D2.2 (A), Q2.1 (B)
unnamed: D3.1 (K), R17.1
unnamed: D4.1 (K), R20.1
unnamed: D5.1 (K), R21.1
unnamed: J1.1, R3.1, R4.1
unnamed: J13.1, SW4.2 (B)
unnamed: J13.2, SW4.1 (A)
unnamed: J19.A5 (CC1), R91.2
unnamed: J19.B5 (CC2), R92.2
unnamed: J20.10 (CK+), R89.2
unnamed: J20.12 (CK-), R90.2
unnamed: J20.7 (D0+), R87.2
unnamed: J20.9 (D0-), R88.2
unnamed: J20.4 (D1+), R85.2
unnamed: J20.6 (D1-), R86.2
unnamed: J20.1 (D2+), R83.2
unnamed: J20.3 (D2-), R84.2
unnamed: J21.R2, JP10.4
unnamed: JP2.2 (B), Q1.3 (C), R11.2
unnamed: JP7.1 (A), R72.1, U10.8 (IOR)
unnamed: JP7.3 (B), R73.2
unnamed: C46.2, JP7.2 (C), R81.1, U11.2 (-)
unnamed: JP8.1 (A), R69.1, U10.6 (IOL)
unnamed: JP8.3 (B), R74.2
unnamed: C47.2, JP8.2 (C), R82.1, U11.6 (-)
unnamed: J21.S, JP10.1 (A)
unnamed: Q1.1 (B), R9.2, R10.1
unnamed: Q2.2 (E), R17.2
unnamed: J7.5, Q3.3 (D), R49.1, U13.1
unnamed: J7.6, Q4.3 (D), R50.1, U13.4
unnamed: J7.1, Q5.3 (D), R52.1, U13.3
unnamed: J7.2, Q6.3 (D), R53.1, U13.6
unnamed: R32.2, R33.2, R39.2, R47.1
unnamed: R34.2, R39.1, R40.2
unnamed: R35.2, R40.1, R41.2
unnamed: R36.2, R41.1, R42.2
unnamed: R37.2, R42.1, R43.2
unnamed: R38.2, R43.1, R44.2
unnamed: R45.2, R54.1, SW2.1
unnamed: R16.1, U3.3 (GPIO6)
unnamed: TP4.1 (1_1), U3.39 (GPIO31)
unnamed: TP5.1 (1_1), U3.40 (GPIO32)
unnamed: TP6.1 (1_1), U3.42 (GPIO33)
unnamed: TP7.1 (1_1), U3.57 (GPIO46_ADC6)
unnamed: R8.1, U3.35 (RUN)
unnamed: R15.1, U3.66 (USB_DM)
unnamed: R14.1, U3.67 (USB_DP)
unnamed: C6.1, U3.30 (XIN), Y1.1
unnamed: R7.1, U3.31 (XOUT)
unnamed: TP2.1 (1_1), U4.1 (32KHZ)
unnamed: TP3.1 (1_1), U4.3 (~INT/SQW)
unnamed: TP1.1 (1_1), U4.4 (~RST)
unnamed: R22.1, U8.17 (GPIO2)
unnamed: R23.1, U8.7 (GPIO13)
unnamed: R24.1, U8.16 (GPIO15)
unnamed: C37.2, U9.12 (DCP), U9.14 (V33)
unnamed: R46.1, U9.9 (REF)
unnamed: C36.2, R51.2, U9.13 (VCC)
unnamed: C41.1, U10.7 (REF)
unnamed: C44.1, C45.1, R75.2, R76.1, U11.3 (+), U11.5 (+)

Notes on the sheet:
Famicom (Dendy) joysticks NOT SEGA!
I2S and PWM audio share GPIO pins and cannot be used simultaneously. Some firmware builds support both audio output modes, while others require separate UF2 files for each mode.
WiFi
USB hub
Sound
FLASH & RAM
Buttons
LEDs
SD card
Note: The Abracon AOTA-B201610S3R3-101-T inductor (3.3 µH) is strongly recommended for the RP2350's internal switching regulator. Generic 3.3 µH inductors are not guaranteed to provide equivalent performance. Observe the polarity dot during assembly.
CVBS
HDMI, VGA, and CVBS share GPIO pins and cannot be used simultaneously. Some firmwares automatically detect the connected video output, while others require separate UF2 files for each video output type.
VGA
HDMI
Tape
1. QE bit is mandatory! 2. Some firmwares operate the SPI flash close to its performance limits. Use only a genuine Winbond chip to ensure reliable operation.
RTC
Joysticks
MCU
Power in / USB device
Alternative microSD slot
Power
Keyboard/Mouse

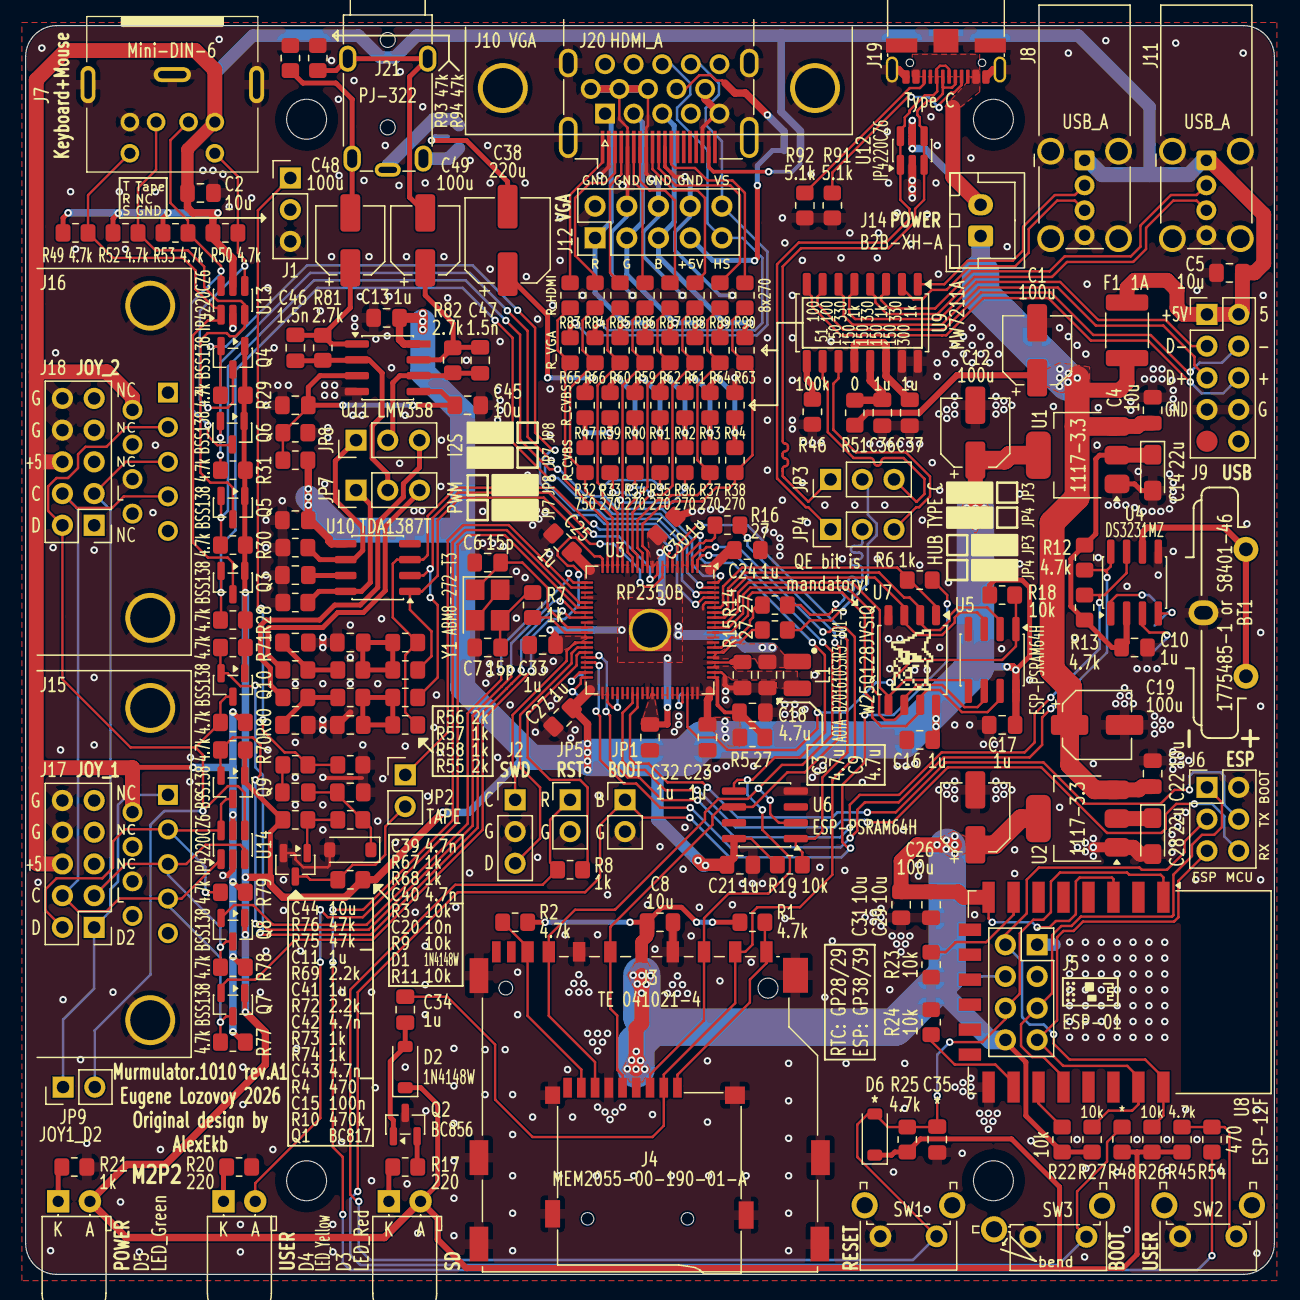
[picture p15: board murmulator1010.kicad_pcb from above]

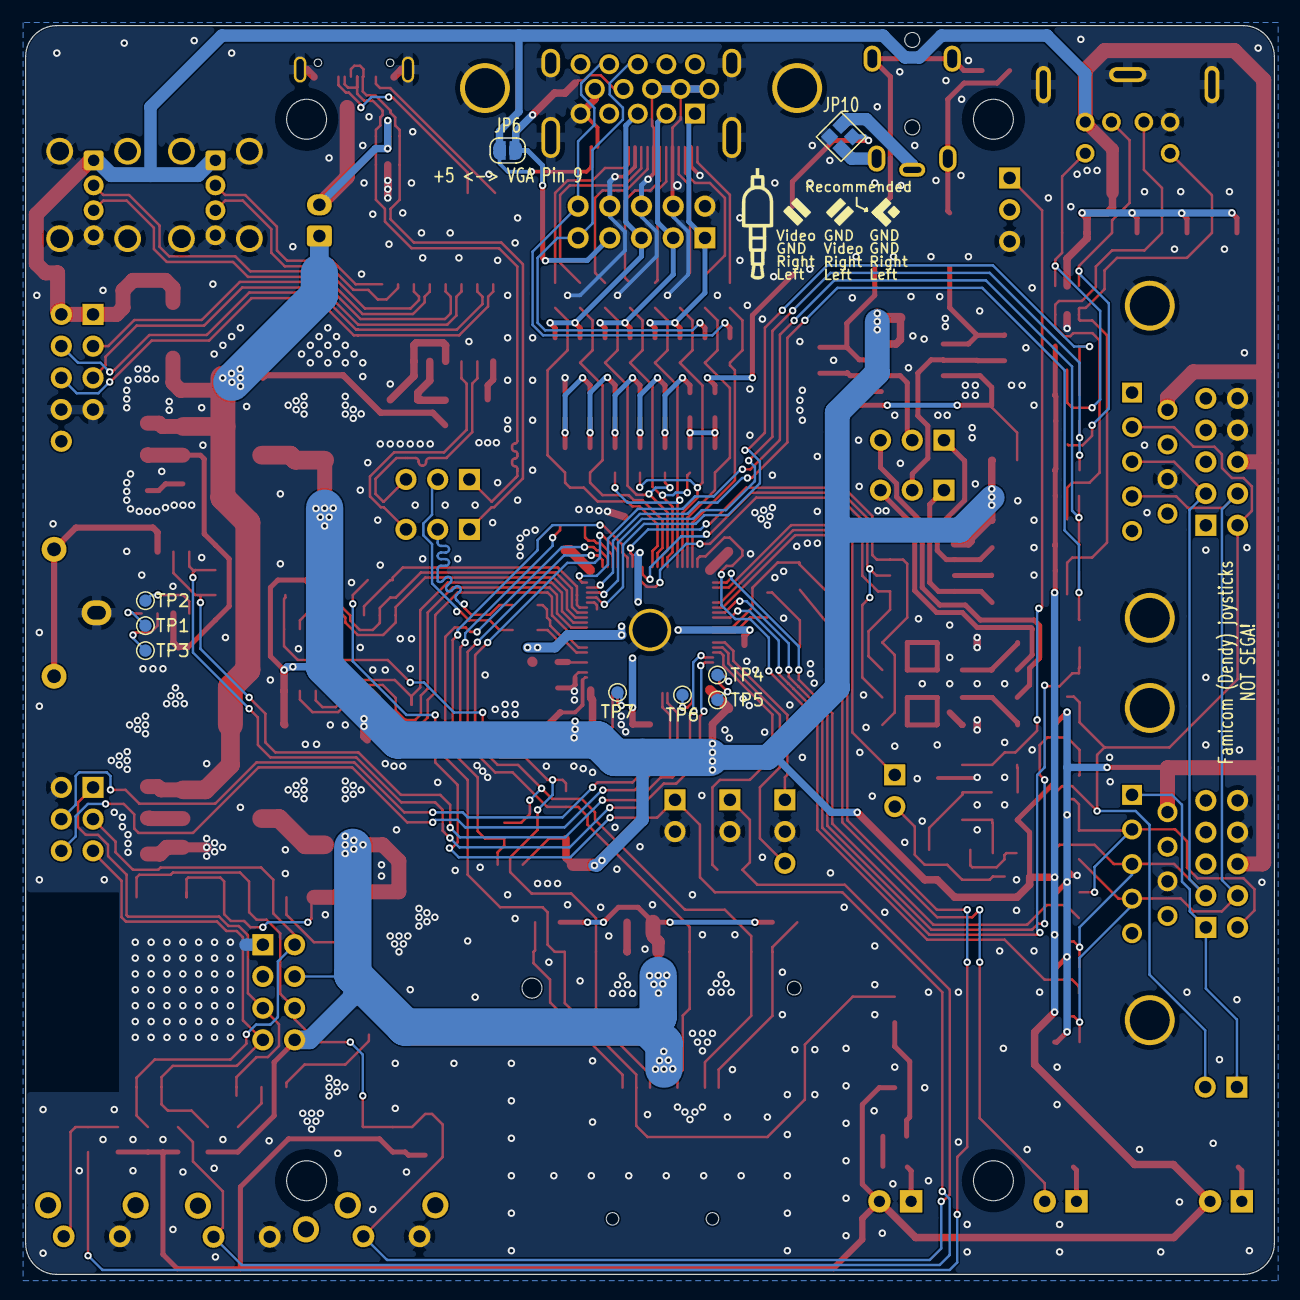
[picture p16: board murmulator1010.kicad_pcb from below]

Board: 2 copper layers, 100.0 x 100.0 mm, 222 parts (9 on the bottom side), 153 nets.
