UzixLS/murmulator1010-board/(commit log)

2026-08-05 wip pcb rev.A
    [murmulator1010.kicad_pcb, murmulator1010.kicad_sch, murmulator1010_covers.kicad_pcb, murmulator1010_covers.kicad_sch]
2026-10-11 pcb rev.A final version
    [murmulator1010_covers.kicad_pcb]
2026-11-11 add pcb rev.A1
    [murmulator1010.kicad_pcb, murmulator1010.kicad_sch, murmulator1010_covers.kicad_pcb, murmulator1010_covers.kicad_sch]
